tadanohiroyuki/panel-type-scalar-arm/パネル型スカラアーム/CSPPN-ST-M2_6-10_STEP_AP203AP214/CSPPN-ST-M2_6-10_203.STEP

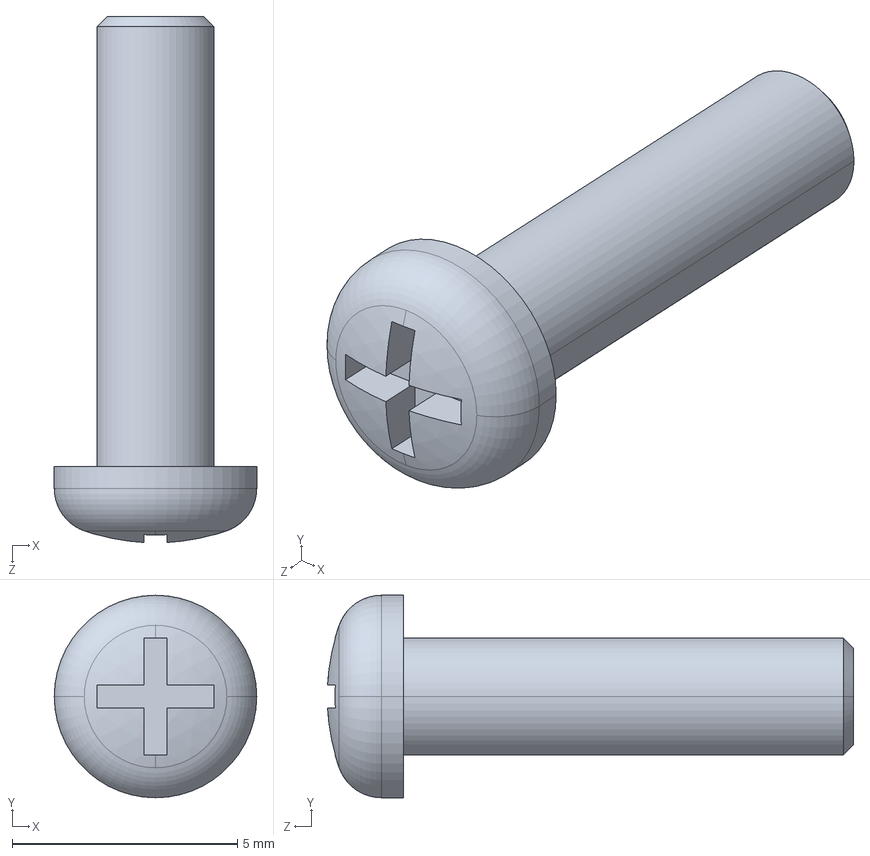
[picture p1: CAD file, 2022-12-17]
パネル型スカラアーム/CSPPN-ST-M2_6-10_STEP_AP203AP214/CSPPN-ST-M2_6-10_203.STEP
4.50 x 4.50 x 11.7 mm
