tadanohiroyuki/panel-type-scalar-arm/パネル型スカラアーム/CSPPN-ST-M2_6-8_STEP_AP203AP214/CSPPN-ST-M2_6-8_214.STEP

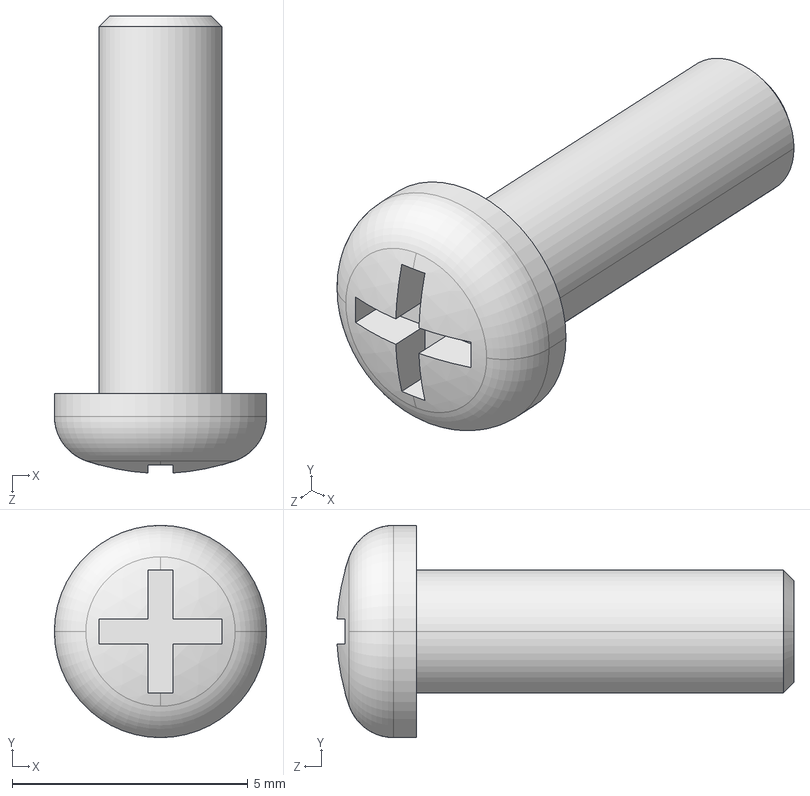
[picture p2: CAD file, 2022-12-19]
パネル型スカラアーム/CSPPN-ST-M2_6-8_STEP_AP203AP214/CSPPN-ST-M2_6-8_214.STEP
4.50 x 4.50 x 9.69 mm
