tadanohiroyuki/panel-type-scalar-arm/パネル型スカラアーム/CSPPN-ST-M3-6_STEP_AP203AP214/CSPPN-ST-M3-6_203.STEP

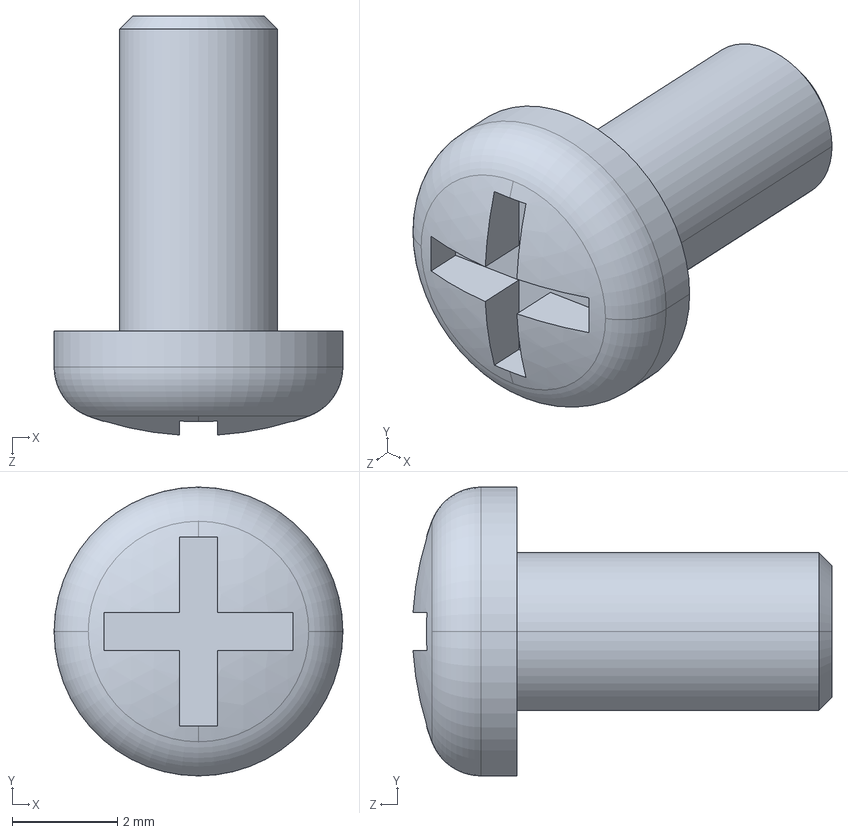
[picture p3: CAD file, 2022-12-14]
パネル型スカラアーム/CSPPN-ST-M3-6_STEP_AP203AP214/CSPPN-ST-M3-6_203.STEP
5.50 x 5.50 x 7.98 mm
