tadanohiroyuki/panel-type-scalar-arm/パネル型スカラアーム/CSPSL-ST3W-M2_6-10_STEP_AP203AP214/CSPSL-ST3W-M2_6-10_214.STEP

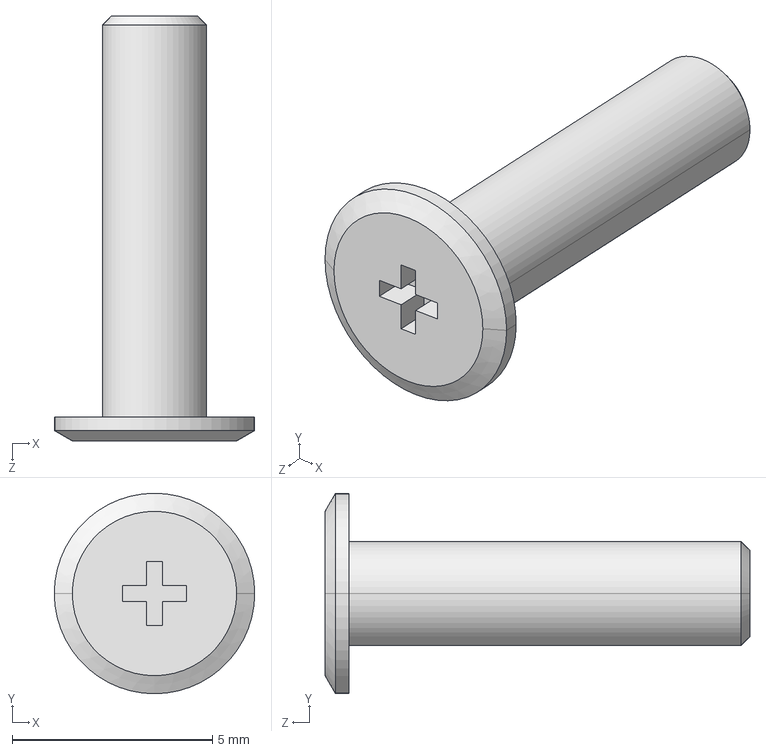
[picture p4: CAD file, 2022-12-14]
パネル型スカラアーム/CSPSL-ST3W-M2_6-10_STEP_AP203AP214/CSPSL-ST3W-M2_6-10_214.STEP
5.00 x 5.00 x 10.6 mm
