tadanohiroyuki/panel-type-scalar-arm/パネル型スカラアーム/サーボ固定パーツ３Dプリンタ出力実験/サーボモータ固定用１軸目.stl

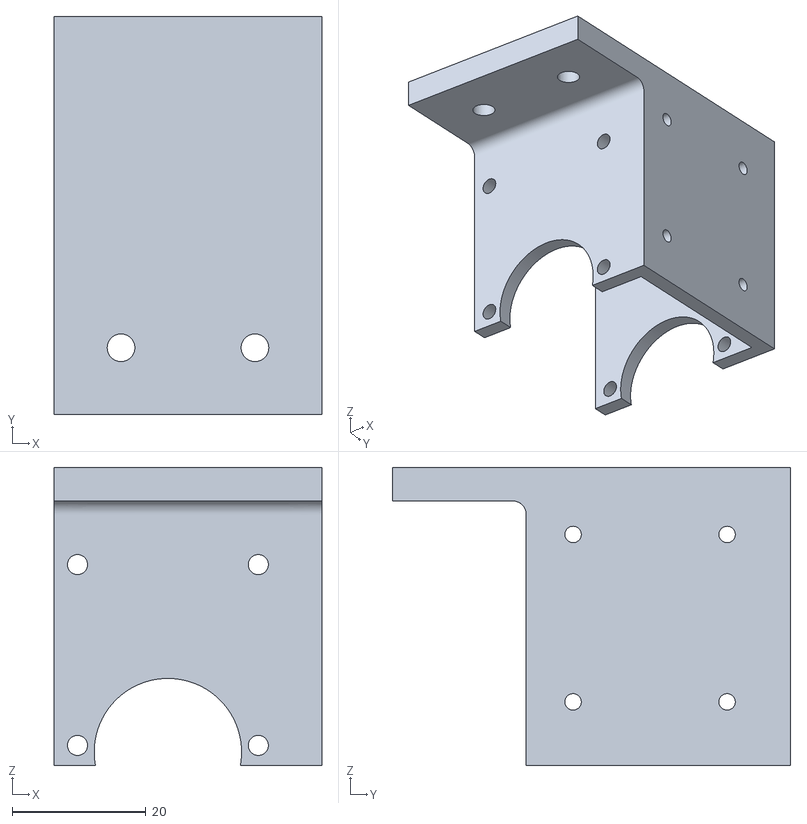
[picture p5: CAD file, 2023-01-19]
パネル型スカラアーム/サーボ固定パーツ３Dプリンタ出力実験/サーボモータ固定用１軸目.stl
40.0 x 59.5 x 44.5
