tadanohiroyuki/panel-type-scalar-arm/パネル型スカラアーム/サーボ固定パーツ３Dプリンタ出力実験/シャフト固定用.stl

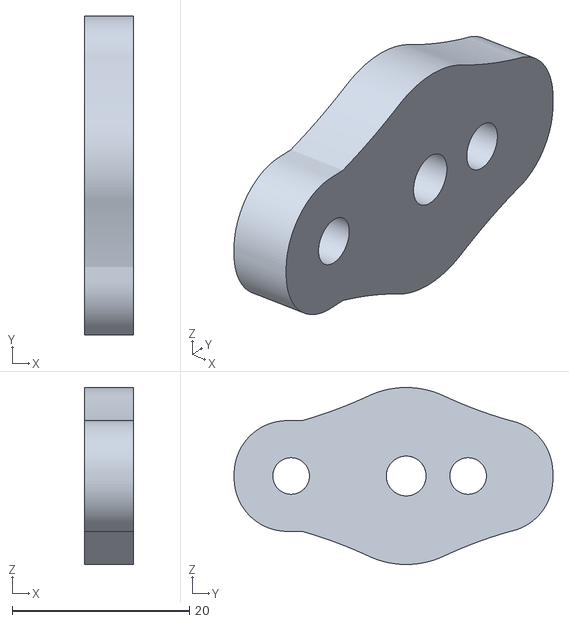
[picture p6: CAD file, 2023-01-19]
パネル型スカラアーム/サーボ固定パーツ３Dプリンタ出力実験/シャフト固定用.stl
5.50 x 36.0 x 20.0
