tadanohiroyuki/panel-type-scalar-arm/パネル型スカラアーム/サーボ固定パーツ３Dプリンタ出力実験/サーボモータ固定用２軸目3mm改_new.stl

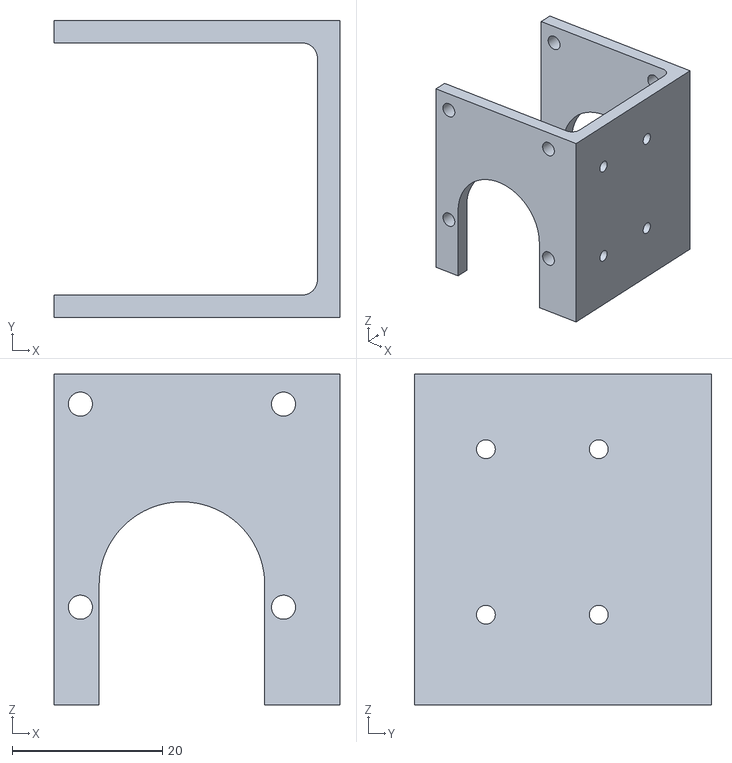
[picture p7: CAD file, 2023-01-19]
パネル型スカラアーム/サーボ固定パーツ３Dプリンタ出力実験/サーボモータ固定用２軸目3mm改_new.stl
38.0 x 39.5 x 44.0
