tadanohiroyuki/panel-type-scalar-arm/(list of files, cad)

Other CAD files:
パネル型スカラアーム/サーボ固定パーツ３Dプリンタ出力実験/soiya.dwg
パネル型スカラアーム/パネル型スカラアーム.dwg
パネル型スカラアーム/CSPPN-ST-M2_6-10_STEP_AP203AP214/CSPPN-ST-M2_6-10_214.STEP
パネル型スカラアーム/CSPPN-ST-M2_6-8_STEP_AP203AP214/CSPPN-ST-M2_6-8_203.STEP
パネル型スカラアーム/CSPPN-ST-M3-6_STEP_AP203AP214/CSPPN-ST-M3-6_214.STEP
パネル型スカラアーム/CSPSL-ST3W-M2_6-10_STEP_AP203AP214/CSPSL-ST3W-M2_6-10_203.STEP
パネル型スカラアーム/orne-box.dwg
パネル型スカラアーム/後ろカバー.dwg
パネル型スカラアーム/前下カバーサーボ隠し.dwg
パネル型スカラアーム/前アクリル板.dwg
パネル型スカラアーム/フラット.dwg
パネル型スカラアーム/3Dプリンタ出力加工品.dwg
パネル型スカラアーム/CBE3-20.ipt
パネル型スカラアーム/CBE5-20.ipt
パネル型スカラアーム/CBE5-25.ipt
パネル型スカラアーム/CSPPN-ST-M2_6-10_203.ipt
パネル型スカラアーム/CSPPN-ST-M2_6-18_203.ipt
パネル型スカラアーム/CSPPN-ST-M2_6-8_STEP_AP203AP214/CSPPN-ST-M2_6-8_203.ipt
パネル型スカラアーム/CSPPN-ST-M3-6_STEP_AP203AP214/CSPPN-ST-M3-6_203.ipt
パネル型スカラアーム/CSPPN-STC-M3-6CSPPN-ST-M3-10_203 - コピー.ipt
パネル型スカラアーム/CSPPN-STC-M3-6CSPPN-ST-M3-6_203.ipt
パネル型スカラアーム/CSPSL-ST3W-M2_6-10_STEP_AP203AP214/サーボホーンとアーム固定するねじCSPSL-ST3W-M2_6-10_203.ipt
パネル型スカラアーム/FL674ZZベアリング.ipt
パネル型スカラアーム/HFS5-2040-180-Z5-YA10-YB170-Left.ipt
パネル型スカラアーム/HFS5-2040-180-Z5-YA10-YB170.ipt
パネル型スカラアーム/HFS5-2040-180-Z5-YA10-YB99-YC170.ipt
パネル型スカラアーム/HFS5-2040-320-TPW-Z5-YA42_5.ipt
パネル型スカラアーム/HFS5-2040-320-TPW.ipt
パネル型スカラアーム/OldVersions/3Dプリンタ出力加工品.0001.dwg
パネル型スカラアーム/OldVersions/AIS2022/SC 0406CP2-part.ipt
パネル型スカラアーム/OldVersions/CBE3-20.0001.ipt
パネル型スカラアーム/OldVersions/CBE3-20.ipt
パネル型スカラアーム/OldVersions/CBE5-20.0001.ipt
パネル型スカラアーム/OldVersions/CSPPN-ST-M2_6-10_STEP_AP203AP214/CSPPN-ST-M2_6-10_214.STEP
パネル型スカラアーム/OldVersions/CSPPN-ST-M3-6_STEP_AP203AP214/CSPPN-ST-M3-6_203.ipt
パネル型スカラアーム/OldVersions/CSPPN-ST-M3-6_STEP_AP203AP214/CSPPN-ST-M3-6_214.STEP
パネル型スカラアーム/OldVersions/CSPPN-ST-M3-6_STEP_AP203AP214/OldVersions/CSPPN-STC-M3-6CSPPN-ST-M3-10_203 - コピー.0002.ipt
パネル型スカラアーム/OldVersions/CSPPN-ST-M3-6_STEP_AP203AP214/OldVersions/CSPPN-STC-M3-6CSPPN-ST-M3-6_203.0003.ipt
パネル型スカラアーム/OldVersions/CSPSL-ST3W-M2_6-10_STEP_AP203AP214/CSPSL-ST3W-M2_6-10_203.STEP
パネル型スカラアーム/OldVersions/CSPSL-ST3W-M2_6-10_STEP_AP203AP214/サーボホーンとアーム固定するねじCSPSL-ST3W-M2_6-10_203.ipt
パネル型スカラアーム/OldVersions/FL674ZZ.0001.ipt
パネル型スカラアーム/OldVersions/HFS5-2040-180-Z5-YA10-YB101-YC170.ipt
パネル型スカラアーム/OldVersions/HFS5-2040-180-Z5-YA10-YB170-Left.0002.ipt
パネル型スカラアーム/OldVersions/HFS5-2040-180-Z5-YA10-YB170.ipt
パネル型スカラアーム/OldVersions/HFS5-2040-180-Z5-YA10-YB99-YC170.0001.ipt
パネル型スカラアーム/OldVersions/HFS5-2040-320-TPW-Z5-YA62_5.ipt
パネル型スカラアーム/OldVersions/HFSF5-2040-180-LMH-RMH.0004.ipt
パネル型スカラアーム/OldVersions/HFSF5-2040-180-LMH-RMH.ipt
パネル型スカラアーム/OldVersions/HFSF5-2040-180-LWH-RWH Left.0005.ipt
パネル型スカラアーム/OldVersions/HFSF5-2040-180-LWH-RWH Left.ipt
パネル型スカラアーム/OldVersions/HFSF5-2040-180-LWH-RWH.0004.ipt
パネル型スカラアーム/OldVersions/HFSF5-2040-180-LWH-RWH.ipt
パネル型スカラアーム/OldVersions/HFSF5-2040-320-TPW.0008.ipt
パネル型スカラアーム/OldVersions/HFSF5-2040-320-TPW.ipt
パネル型スカラアーム/OldVersions/これで完成パネル型スカラアーム.0012.iam
パネル型スカラアーム/OldVersions/サーボモータ.iam
パネル型スカラアーム/OldVersions/サーボモータB3M-SC-1170-AB3M1100_scale.0004.ipt
パネル型スカラアーム/OldVersions/サーボモータB3M-SC-1170-AB3M1100_scale.ipt
パネル型スカラアーム/OldVersions/サーボモータ固定用２軸目.0017.ipt
パネル型スカラアーム/OldVersions/サーボモータ固定用２軸目.ipt
パネル型スカラアーム/OldVersions/シャフト4.ipt
パネル型スカラアーム/OldVersions/シャフトカラー.iam
パネル型スカラアーム/OldVersions/パネル型スカラアーム.0001.dwg
パネル型スカラアーム/OldVersions/パネル型スカラアーム.0033.iam
パネル型スカラアーム/OldVersions/パネル型スカラアームMISUMIアルミフレーム作成Ver.0048.iam
パネル型スカラアーム/OldVersions/パネル型スカラアームMISUMIアルミフレーム作成Ver.iam
パネル型スカラアーム/OldVersions/フラット.0001.dwg
パネル型スカラアーム/OldVersions/三段目アクリル板.0007.ipt
パネル型スカラアーム/OldVersions/前アクリル板.0002.dwg
パネル型スカラアーム/OldVersions/前カバー中段右.0014.ipt
パネル型スカラアーム/OldVersions/前カバー中盤.0013.ipt
パネル型スカラアーム/OldVersions/前カバー中盤左アーム固定.0028.ipt
パネル型スカラアーム/OldVersions/後ろカバー.0001.dwg
パネル型スカラアーム/OldVersions/後ろカバー.0010.ipt
パネル型スカラアーム/OldVersions/横長2ndフラットバー上 アルミフレーム用.0017.ipt
パネル型スカラアーム/OldVersions/横長2ndフラットバー上.0007.ipt
パネル型スカラアーム/OldVersions/横長2ndフラットバー上.ipt
パネル型スカラアーム/OldVersions/横長2ndフラットバー下 アルミフレーム用.0019.ipt
パネル型スカラアーム/OldVersions/横長2ndフラットバー下.ipt
パネル型スカラアーム/OldVersions/横長3rdフラットバー.0003.ipt
パネル型スカラアーム/OldVersions/横長3rdフラットバー上.0005.ipt
パネル型スカラアーム/OldVersions/横長3rdフラットバー下.0011.ipt
パネル型スカラアーム/OldVersions/横長フラットバー.ipt
パネル型スカラアーム/OldVersions/縦長3rdフラットバー.ipt
パネル型スカラアーム/OldVersions/縦長3rdフラットバーアルミフレーム用.ipt
パネル型スカラアーム/OldVersions/縦長フラットバー右.ipt
パネル型スカラアーム/OldVersions/縦長フラットバー左.0010.ipt
パネル型スカラアーム/OldVersions/縦長フラットバー左.ipt
パネル型スカラアーム/OldVersions/黒棒.0006.ipt
パネル型スカラアーム/OldVersions/１段目アーム.iam
パネル型スカラアーム/サーボモータB3M-SC-1170-AB3M1100_scale.ipt
パネル型スカラアーム/サーボモータB3M1000_scale.ipt
パネル型スカラアーム/サーボ固定パーツ３Dプリンタ出力実験/OldVersions/Part1.0003.ipt
パネル型スカラアーム/サーボ固定パーツ３Dプリンタ出力実験/OldVersions/soiya.0003.ipt
パネル型スカラアーム/サーボ固定パーツ３Dプリンタ出力実験/OldVersions/これで完成パネル型スカラアーム.0004.iam
パネル型スカラアーム/サーボ固定パーツ３Dプリンタ出力実験/OldVersions/サーボモータ固定用１軸目.0028.ipt
パネル型スカラアーム/サーボ固定パーツ３Dプリンタ出力実験/OldVersions/サーボモータ固定用２軸目2mm.0017.ipt
パネル型スカラアーム/サーボ固定パーツ３Dプリンタ出力実験/OldVersions/サーボモータ固定用２軸目2mm改.ipt
パネル型スカラアーム/サーボ固定パーツ３Dプリンタ出力実験/OldVersions/サーボモータ固定用２軸目3mm改.0035.ipt
パネル型スカラアーム/サーボ固定パーツ３Dプリンタ出力実験/OldVersions/サーボモータ固定用２軸目3mm改.ipt
パネル型スカラアーム/サーボ固定パーツ３Dプリンタ出力実験/OldVersions/サーボモータ固定用２軸目3mm改.stl
パネル型スカラアーム/サーボ固定パーツ３Dプリンタ出力実験/OldVersions/サーボモータ固定用２軸目3mm改_new.0006.ipt
パネル型スカラアーム/サーボ固定パーツ３Dプリンタ出力実験/OldVersions/サーボモータ固定用２軸目3mm改_printer.0001.ipt
パネル型スカラアーム/サーボ固定パーツ３Dプリンタ出力実験/OldVersions/サーボモータ固定用２軸目3mm改neo.0001.ipt
パネル型スカラアーム/サーボ固定パーツ３Dプリンタ出力実験/OldVersions/サーボモータ固定用２軸目4mm改.0028.ipt
パネル型スカラアーム/サーボ固定パーツ３Dプリンタ出力実験/OldVersions/サーボモータ固定用２軸目4mm改.ipt
パネル型スカラアーム/サーボ固定パーツ３Dプリンタ出力実験/OldVersions/サーボモータ固定用２軸目4mm改.stl
パネル型スカラアーム/サーボ固定パーツ３Dプリンタ出力実験/OldVersions/サーボモータ固定用２軸目5mm改.ipt
パネル型スカラアーム/サーボ固定パーツ３Dプリンタ出力実験/OldVersions/サーボモータ固定用２軸目5mm改.stl
パネル型スカラアーム/サーボ固定パーツ３Dプリンタ出力実験/OldVersions/シャフト固定用.0009.ipt
パネル型スカラアーム/サーボ固定パーツ３Dプリンタ出力実験/Part1.ipt
パネル型スカラアーム/サーボ固定パーツ３Dプリンタ出力実験/soiya.ipt
パネル型スカラアーム/サーボ固定パーツ３Dプリンタ出力実験/サーボモータ固定用１軸目.ipt
パネル型スカラアーム/サーボ固定パーツ３Dプリンタ出力実験/サーボモータ固定用２軸目3mm改.ipt
パネル型スカラアーム/サーボ固定パーツ３Dプリンタ出力実験/サーボモータ固定用２軸目3mm改_new.ipt
パネル型スカラアーム/サーボ固定パーツ３Dプリンタ出力実験/サーボモータ固定用２軸目4mm改.ipt
パネル型スカラアーム/サーボ固定パーツ３Dプリンタ出力実験/シャフト固定用.ipt
パネル型スカラアーム/シャフト4.ipt
パネル型スカラアーム/パネル型スカラアーム.iam
パネル型スカラアーム/三段目アクリル板.ipt
パネル型スカラアーム/前カバー中段右.ipt
パネル型スカラアーム/前カバー中盤左アーム固定.ipt
パネル型スカラアーム/後ろカバー.ipt
パネル型スカラアーム/横長2ndフラットバー.ipt
パネル型スカラアーム/横長2ndフラットバー上 アルミフレーム用.ipt
パネル型スカラアーム/横長2ndフラットバー上.ipt
パネル型スカラアーム/横長3rdフラットバー下.ipt
パネル型スカラアーム/黒棒.ipt
