tadanohiroyuki/panel-type-scalar-arm/(threads)

Thread 2 (2022-11-24):

根本を駆動するモータ

yasuohayashibara, 2022-11-24:
根本関節を駆動するモータは１つで良いと思います．
一つは受動関節で良いと思います．

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

tadanohiroyuki, 2022-11-25:
まだ具体的なアイディア設計には取り入れられてないです.
受動関節の良い方法模索中です.

yasuohayashibara, 2022-11-25:
表現間違っていましたが，動力の無い受動的な部品となります．
軸とベアリングがあれば良いと思います．

tadanohiroyuki, 2022-11-26:
下のサーボモータ取り外して設計変更してみます.
現状,軸（シャフト）とサーボモータ固定する方法がわからないです.そもそも固定する必要ないでしょうか.

yasuohayashibara, 2022-11-27:
質問が分かりません．
他の機構ではどうしているか調査したほうが良いと思います．
林原としては上記で示したように軸とベアリングで回転する関節を設計すれば良いと思います．
簡単な図を書いて質問をしてくれるとアドバイスできると思います．

yasuohayashibara, 2022-12-08:
ベアリングが２つ使用されています．
一般的には下はベアリングではなく軸をフレームに固定すると思います．

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

tadanohiroyuki, 2022-12-12:
ベアリング一個に変更し下のアルミフレームとシャフトを固定しました

yasuohayashibara, 2022-12-13:
はい．
issueを閉じます．

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

Closed 2022-12-13.

Thread 3 (2022-11-24):

板同士の接合方法

yasuohayashibara, 2022-11-24:
板同士の接合方法が示されていません．

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

tadanohiroyuki, 2022-11-25:
ここの接合方法はどうしたらいいでしょうか？
L字金具しか思い浮かばないです.他に方法がないか今からホームセンター行って見てきます.

yasuohayashibara, 2022-11-25:
この板材の素材と加工法で取れる手段が変わります．
ちなみに，L字金具の場合，モータの取り付け用のコの字型の部品と干渉しそうな気がします．
何かを入れるスペースは残っていなさそうな気がします．

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

tadanohiroyuki, 2022-11-25:
アルミの長いフラットバーを買って,枠のサイズ合わせて4本に切っていくのが早いのかなと考えていました.

L字金具の場合入れるスペース作ります.

yasuohayashibara, 2022-11-25:
フラットバーとは角柱のことでしょうか．
上下（前後）の板もそれで固定するということですね．

tadanohiroyuki, 2022-11-26:
そうです.
[https://nikkal.net/archives/2009/04/post-56.html](url)

他に手段なさそうでしたらそれで固定してみます.

yasuohayashibara, 2022-11-27:
具体的にどう固定するのか知りたいので図面に反映させて下さい．

tadanohiroyuki, 2022-12-06:
アルミフレームに変更しました.

yasuohayashibara, 2022-12-08:
大きな穴が貫通しているので，ネジで固定できないと思います．

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

tadanohiroyuki, 2022-12-12:
ザグリ穴を追加工します.設計に反映させました.

yasuohayashibara, 2022-12-13:
変更した部分をできれば画像で付けて下さい．
反映されていないように見えます．

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

yasuohayashibara, 2022-12-13:
別件の板同士の接合ということでは，前のパネルをどのように接合するのかが示されていません．

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

yasuohayashibara, 2022-12-13:
部品リストを見るとレンチ穴を開けていますが，これを利用して固定するためには専用の部品が必要です．
HFSF5-2040-180-LWH-RWH

全てをチェックしきれたわけではありませんが，もしこれを採用するのであれば固定用の部品が必要です．

以下のページのレンチ穴を参照
https://jp.misumi-ec.com/special/alumiframe/additional_machining/detail/

tadanohiroyuki, 2022-12-14:
MISUMIのアルミフレーム加工サービスをレンチ穴からザグリ穴に変更しました．ねじ固定問題は解決できたかと思います．

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

tadanohiroyuki, 2022-12-16:
先輩からアドバイス頂きまして変更しております。
設計に反映でき次第gitの方の設計更新します。

tadanohiroyuki, 2022-12-17:
設計更新しました
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

yasuohayashibara, 2022-12-21:
> ここはカバーとしての役割しかないため簡易的な接着，両面テープを使用するのはありでしょうか．

あまり感心できない方法ですが，時間が無いのでこちらを採用しましょう．
issueを閉じます．

Closed 2022-12-21.

Thread 4 (2022-11-24):

サーボモータと板との接合方法

yasuohayashibara, 2022-11-24:
サーボモータと板との接合方法が示されていません．

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

tadanohiroyuki, 2022-11-25:
サーボホーンとアームをネジ止め固定します.アームに固定用の穴を空けていなかったため空けます.

yasuohayashibara, 2022-11-25:
確認しますのでデータをアップロードして下さい．

tadanohiroyuki, 2022-11-26:
こちらもアップロードしました.

yasuohayashibara, 2022-11-27:
#7 で述べたことですが，こちらの議論につながるissueですので，こちらに移動します．

サーボモータの出力とは反対側の軸の固定方法ですが，２つの点で問題があります．

１）ベアリングが無いので滑りません．

２）矢印方向に少しでも力が加わるとプラスチックがたわんで外れます．
　　逆にたわまない場合は組立てが組立てが難しいかもしれません．

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

問題となる部分
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

この穴で支えるのは難しいと思います．
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

yasuohayashibara, 2022-11-27:
ちなみに，B3Mサーボモータには出力と反対の軸を固定するための部品もあります．
このような場合は一般的にはこの部品を使います．

ちなみに，出力と反対の方向に軸が出ていますが，この部品を取り付けるための突起です．

https://kondo-robot.com/product/02137

tadanohiroyuki, 2022-12-06:
追加しました.

Closed 2022-12-13.

Thread 5 (2022-11-24):

ネジの隙間

yasuohayashibara, 2022-11-24:
ネジの隙間が充分かを確認して下さい．
ネジの頭が干渉している場合は，設計を変更することが必要となります．

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

tadanohiroyuki, 2022-11-25:
2mmほどの隙間しかなかったため3mmに拡張しました.

yasuohayashibara, 2022-11-25:
新しいデータがアップロードされていませんので，アップロードして下さい．

tadanohiroyuki, 2022-11-26:
こちらもアップロードしました

yasuohayashibara, 2022-11-27:
3mmであることを確認しました．
issueを閉じます．

Closed 2022-11-27.

Thread 6 (2022-11-25):

サーボモータを固定する部品の製作方法

yasuohayashibara, 2022-11-25:
サーボモータを固定する部品の製作方法
以下の部品の製作は難しい気がしますが，大丈夫でしょうか？

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

yasuohayashibara, 2022-11-25:
こちらの部品に関してはタップ加工をしないと組立てられない気がします．
あと，穴が不足しています．

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

tadanohiroyuki, 2022-11-25:
3Dプリンタでは強度の面など厳しいでしょうか,,,？
アルミで製作するのであれば加工依頼出すしかないでしょうか.

穴不足は解決しました.

yasuohayashibara, 2022-11-25:
3Dプリンタで出力した部品にタップは立てられないと思います．
確信は無いですが，少なくとも2mm厚の板では無理だと思います．
できれば調査していただければと思います．

上記の形状はおそらく加工依頼を出しても作ってもらえない加工だと思います．
元の金属材料と加工法にもよりますが，ちょうどよいチャンネル材がないと大変な加工になります．

tadanohiroyuki, 2022-11-25:
厚みなど増やす必要はありますがタップできなくはなさそうです.](https://youtu.be/NdvDsJ-Y_HA)
無理そうならナット入れる穴作ってナット固定に切り替えます.
タップできるかと強度調べるため,2mm~5mmのたサーボ固定する部品作って調査してみます.

yasuohayashibara, 2022-11-25:
> 厚みなど増やす必要はありますがタップできなくはなさそうです.](https://youtu.be/NdvDsJ-Y_HA)

調査ありがとう．
強度的に心配なところはありそうな気がしますが，試作してみると良いと思います．

> タップできるかと強度調べるため,2mm~5mmのたサーボ固定する部品作って調査してみます.

それが良いと思います．
おそらく薄い板を垂直方向に積層することに関しても問題が発生するおそれがあります．

Thread 7 (2022-11-27):

サーボモータの出力とは反対の軸の固定方法

yasuohayashibara, 2022-11-27:
サーボモータの出力とは反対側の軸の固定方法ですが，２つの点で問題があります．

１）ベアリングが無いので滑りません．

２）矢印方向に少しでも力が加わるとプラスチックがたわんで外れます．
　　逆にたわまない場合は組立てが組立てが難しいかもしれません．

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

問題となる部分
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

この穴で支えるのは難しいと思います．
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

yasuohayashibara, 2022-11-27:
ちなみに，B3Mサーボモータには出力と反対の軸を固定するための部品もあります．
このような場合は一般的にはこの部品を使います．

https://kondo-robot.com/product/02137

yasuohayashibara, 2022-11-27:
#4 に同じissueがありましたので，この内容をコピーして閉じます．

Closed 2022-11-27.
