tadanohiroyuki/panel-type-scalar-arm/(commit log)

2022-11-24 パネル型スカラアーム
    [02137_AluminumFreeHornWithBearing_B3M_6000.stp, B3M1100_scale.stp, アーム支え.ipt, アーム板.ipt, サーボモータ.iam, サーボモータB3M-SC-1170-AB3M1100_scale.0003.ipt, サーボモータB3M-SC-1170-AB3M1100_scale.ipt, サーボモータ固定用.ipt]
2022-11-25 ネジ穴、隙間埋め、ネジ止め用隙間確保
    [アーム支え.ipt, アーム板.ipt, サーボモータB3M-SC-1170-AB3M1100_scale.ipt, サーボ隠し.ipt, パネル型スカラアーム.0039.iam, パネル型スカラアーム.iam, 前カバー中盤.0013.ipt, 横長3rdフラットバー.0003.ipt]
2022-11-28 前方の隙間埋め
    前方の隙間埋め
    [サーボモータ固定用.ipt, サーボモータ固定用１軸目.0013.ipt, サーボモータ固定用１軸目.ipt, サーボモータ固定用１軸目2mm.ipt, サーボモータ固定用２軸目.0017.ipt, サーボモータ固定用２軸目.ipt, サーボモータ固定用２軸目2mm.0017.ipt, サーボモータ固定用２軸目2mm.ipt]
2022-11-30 アルミホーン追加
    [02137_AluminumFreeHornWithBearing_B3M_6000.stp, アルミフリーホーン02137_AluminumFreeHornWithBearing_B3M_6000.ipt, サーボモータ固定用２軸目2mm改.0028.ipt, サーボモータ固定用２軸目2mm改.ipt, サーボモータ固定用２軸目2mm改.stl, サーボモータ固定用２軸目3mm改.0027.ipt, サーボモータ固定用２軸目3mm改.ipt, サーボモータ固定用２軸目3mm改.stl]
2022-12-05 アルミフレーム化
    [02137_AluminumFreeHornWithBearing_B3M_6000.stp, B3M1100_scale.stp, HFSF5-2040-180-LWH-RWH.ipt, HFSF5-2040-320-TPW.0002.ipt, HFSF5-2040-320-TPW.ipt, サーボモータB3M-SC-1170-AB3M1100_scale.0003.ipt, サーボモータB3M-SC-1170-AB3M1100_scale.ipt, サーボモータ固定用１軸目.0013.ipt]
2022-12-05 改良版パネル型スカラアーム
    [HFSF5-2040-320-TPW.0002.ipt, HFSF5-2040-320-TPW.0003.ipt, HFSF5-2040-320-TPW.ipt, シャフト.0001.ipt, シャフト.ipt, シャフトカラー.ipt, パネル型スカラアームMISUMIアルミフレーム作成Ver.0005.iam, パネル型スカラアームMISUMIアルミフレーム作成Ver.0008.iam]
2022-12-06 場所移動
    [パネル型スカラアーム.iam]
2022-12-07 アルミフレームとサーボ固定パーツ用の穴追加
    [HFSF5-2040-180-LWH-RWH.0001.ipt, HFSF5-2040-180-LWH-RWH.ipt, パネル型スカラアームMISUMIアルミフレーム作成Ver.0015.iam, パネル型スカラアームMISUMIアルミフレーム作成Ver.0017.iam, パネル型スカラアームMISUMIアルミフレーム作成Ver.iam]
2022-12-12 ザグリ穴追加とベアリング一個に変更
    [HFSF5-2040-180-LWH-RWH Left.0004.ipt, HFSF5-2040-180-LWH-RWH Left.ipt, HFSF5-2040-180-LWH-RWH.0001.ipt, HFSF5-2040-180-LWH-RWH.0003.ipt, HFSF5-2040-320-TPW.0004.ipt, HFSF5-2040-320-TPW.0007.ipt, HFSF5-2040-320-TPW.ipt, SC 0406CP2-part.ipt]
2022-12-14 ねじ追加
    [CBE3-20.0001.ipt, CBE3-20.ipt, CBE5-20.ipt, CSPPN-ST-M2_6-18_203.ipt, CSPPN-ST-M3-6_203.STEP, CSPPN-ST-M3-6_214.STEP, CSPPN-STC-M3-6CSPPN-ST-M3-10_203 - コピー.0002.ipt, CSPPN-STC-M3-6CSPPN-ST-M3-10_203 - コピー.ipt]
2022-12-16 アーム改良
    [CBE3-20.ipt, CBE5-20.0001.ipt, CBE5-20.ipt, CBE5-25.ipt, FL674ZZ.0001.ipt, FL674ZZ.ipt, HFS5-2040-180-Z5-YA10-YB101-YC170.ipt, HFS5-2040-180-Z5-YA10-YB170-Left.0002.ipt]
2022-12-17 必要箇所のネジ入れ、先輩からアドバイスいただいて設計反映、サーボモータのサイズ変更
    [CSPPN-ST-M2_6-10_203.STEP, CSPPN-ST-M2_6-10_203.ipt, CSPPN-ST-M2_6-10_214.STEP, CSPPN-ST-M3-6_203.ipt, CSPSL-ST3W-M2_6-10_203.STEP, CSPSL-ST3W-M2_6-10_214.STEP, FL674ZZベアリング.ipt, SC 0406CP2-part.ipt]
2022-12-19 Modified version
    [CSPPN-ST-M2_6-10_203.STEP, CSPPN-ST-M2_6-10_203.ipt, CSPPN-ST-M2_6-10_214.STEP, CSPPN-ST-M2_6-18_203.ipt, CSPPN-ST-M3-6_203.STEP, CSPPN-ST-M3-6_203.ipt, CSPPN-ST-M3-6_214.STEP, CSPPN-STC-M3-6CSPPN-ST-M3-10_203 - コピー.0002.ipt]
2022-12-19 M2.6ネジの長さ変更
    [CSPPN-ST-M2_6-8_203.STEP, CSPPN-ST-M2_6-8_203.ipt, CSPPN-ST-M2_6-8_214.STEP, パネル型スカラアーム.0014.iam, パネル型スカラアーム.iam]
2022-12-31 軽微な修正
    [3Dプリンタ出力加工品.0001.dwg, 3Dプリンタ出力加工品.dwg, サーボモータ固定用２軸目3mm改_new.0003.ipt, サーボモータ固定用２軸目3mm改_new.0006.ipt, サーボモータ固定用２軸目3mm改_new.ipt, シャフト固定用.0003.ipt, シャフト固定用.0007.ipt, シャフト固定用.ipt]
